duyu80/wolf/Baseboard/Release/Release/20150523/ReleaseNotes.txt

Baseboard_v0203
Status_v0106

Fix below issue

1) Reverse SGPIO Active signal to solve 20586
2) Correct power enable to solve 20539
