duyu80/wolf/Baseboard/BLD/Baseboard/synlog/report/Baseboard_Baseboard_fpga_mapper_notes.txt

@N: MF248 |Running in 64-bit mode.
@N: MF666 |Clock conversion enabled 
@N: BN362 :"e:\work\wolf\baseboard\bld\..\src\gpi.v":67:0:67:5|Removing sequential instance GPI0_INST.DOUT1[3] in hierarchy view:work.BB_TOP(verilog) because there are no references to its outputs 
@N: BN362 :"e:\work\wolf\baseboard\bld\..\src\gpi.v":79:0:79:5|Removing sequential instance GPI0_INST.DOUT2[3] in hierarchy view:work.BB_TOP(verilog) because there are no references to its outputs 
@N: BN362 :"e:\work\wolf\baseboard\bld\..\src\gpi.v":67:0:67:5|Removing sequential instance GPI8_INST.DOUT1[2] in hierarchy view:work.BB_TOP(verilog) because there are no references to its outputs 
@N: BN362 :"e:\work\wolf\baseboard\bld\..\src\gpi.v":79:0:79:5|Removing sequential instance GPI8_INST.DOUT2[2] in hierarchy view:work.BB_TOP(verilog) because there are no references to its outputs 
@N: BN362 :"e:\work\wolf\baseboard\bld\..\src\gpi.v":67:0:67:5|Removing sequential instance GPI9_INST.DOUT1[1] in hierarchy view:work.BB_TOP(verilog) because there are no references to its outputs 
@N: BN362 :"e:\work\wolf\baseboard\bld\..\src\gpi.v":79:0:79:5|Removing sequential instance GPI9_INST.DOUT2[1] in hierarchy view:work.BB_TOP(verilog) because there are no references to its outputs 
@N: BN362 :"e:\work\wolf\baseboard\bld\..\src\i2c.v":257:0:257:5|Removing sequential instance PORT_CSD1[15] of view:PrimLib.dffr(prim) in hierarchy view:work.I2C(verilog) because there are no references to its outputs 
@N: BN362 :"e:\work\wolf\baseboard\bld\..\src\i2c.v":257:0:257:5|Removing sequential instance PORT_CSD1[14] of view:PrimLib.dffr(prim) in hierarchy view:work.I2C(verilog) because there are no references to its outputs 
@N: BN362 :"e:\work\wolf\baseboard\bld\..\src\i2c.v":257:0:257:5|Removing sequential instance PORT_CSD1[13] of view:PrimLib.dffr(prim) in hierarchy view:work.I2C(verilog) because there are no references to its outputs 
@N: BN362 :"e:\work\wolf\baseboard\bld\..\src\i2c.v":257:0:257:5|Removing sequential instance PORT_CSD1[12] of view:PrimLib.dffr(prim) in hierarchy view:work.I2C(verilog) because there are no references to its outputs 
@N: BN362 :"e:\work\wolf\baseboard\bld\..\src\i2c.v":257:0:257:5|Removing sequential instance PORT_CSD1[11] of view:PrimLib.dffr(prim) in hierarchy view:work.I2C(verilog) because there are no references to its outputs 
@N: BN362 :"e:\work\wolf\baseboard\bld\..\src\i2c.v":257:0:257:5|Removing sequential instance PORT_CSD1[15] of view:PrimLib.dffr(prim) in hierarchy view:work.I2C_I2C_INS_2(verilog) because there are no references to its outputs 
@N: BN362 :"e:\work\wolf\baseboard\bld\..\src\i2c.v":257:0:257:5|Removing sequential instance PORT_CSD1[14] of view:PrimLib.dffr(prim) in hierarchy view:work.I2C_I2C_INS_2(verilog) because there are no references to its outputs 
@N: BN362 :"e:\work\wolf\baseboard\bld\..\src\i2c.v":257:0:257:5|Removing sequential instance PORT_CSD1[13] of view:PrimLib.dffr(prim) in hierarchy view:work.I2C_I2C_INS_2(verilog) because there are no references to its outputs 
@N: BN362 :"e:\work\wolf\baseboard\bld\..\src\i2c.v":257:0:257:5|Removing sequential instance PORT_CSD1[12] of view:PrimLib.dffr(prim) in hierarchy view:work.I2C_I2C_INS_2(verilog) because there are no references to its outputs 
@N: BN362 :"e:\work\wolf\baseboard\bld\..\src\i2c.v":257:0:257:5|Removing sequential instance PORT_CSD1[11] of view:PrimLib.dffr(prim) in hierarchy view:work.I2C_I2C_INS_2(verilog) because there are no references to its outputs 
@N: FX164 |The option to pack flops in the IOB has not been specified 
@N: BW106 |Synplicity Constraint File capacitance units using default value of 1pF 
@N: MT320 |Timing report estimates place and route data. Please look at the place and route timing report for final timing.
@N: MT322 |Clock constraints cover only FF-to-FF paths associated with the clock.
@N: MT320 |Timing report estimates place and route data. Please look at the place and route timing report for final timing.
@N: MT322 |Clock constraints cover only FF-to-FF paths associated with the clock.
