duyu80/wolf/Status/BLD/Status/synlog/report/Status_Status_fpga_mapper_notes.txt

@N: MF248 |Running in 64-bit mode.
@N: MF666 |Clock conversion enabled 
@N: BN362 :"e:\work\wolf\status\bld\..\src\i2c.v":257:0:257:5|Removing sequential instance PORT_CSD1[15] of view:PrimLib.dffr(prim) in hierarchy view:work.I2C(verilog) because there are no references to its outputs 
@N: BN362 :"e:\work\wolf\status\bld\..\src\i2c.v":257:0:257:5|Removing sequential instance PORT_CSD1[14] of view:PrimLib.dffr(prim) in hierarchy view:work.I2C(verilog) because there are no references to its outputs 
@N: BN362 :"e:\work\wolf\status\bld\..\src\i2c.v":257:0:257:5|Removing sequential instance PORT_CSD1[13] of view:PrimLib.dffr(prim) in hierarchy view:work.I2C(verilog) because there are no references to its outputs 
@N: BN362 :"e:\work\wolf\status\bld\..\src\i2c.v":257:0:257:5|Removing sequential instance PORT_CSD1[12] of view:PrimLib.dffr(prim) in hierarchy view:work.I2C(verilog) because there are no references to its outputs 
@N: BN362 :"e:\work\wolf\status\bld\..\src\i2c.v":257:0:257:5|Removing sequential instance PORT_CSD1[11] of view:PrimLib.dffr(prim) in hierarchy view:work.I2C(verilog) because there are no references to its outputs 
@N: BN362 :"e:\work\wolf\status\bld\..\src\i2c.v":257:0:257:5|Removing sequential instance PORT_CSD1[10] of view:PrimLib.dffr(prim) in hierarchy view:work.I2C(verilog) because there are no references to its outputs 
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
@N: BN362 :"e:\work\wolf\status\bld\..\src\i2c.v":257:0:257:5|Removing sequential instance PORT_CS[3] of view:PrimLib.dffr(prim) in hierarchy view:work.I2C(verilog) because there are no references to its outputs 
@N: BN362 :"e:\work\wolf\status\bld\..\src\i2c.v":257:0:257:5|Removing sequential instance PORT_CS[2] of view:PrimLib.dffr(prim) in hierarchy view:work.I2C(verilog) because there are no references to its outputs 
@N: FX164 |The option to pack flops in the IOB has not been specified 
@N: BW106 |Synplicity Constraint File capacitance units using default value of 1pF 
@N: MT320 |Timing report estimates place and route data. Please look at the place and route timing report for final timing.
@N: MT322 |Clock constraints cover only FF-to-FF paths associated with the clock.
@N: MT320 |Timing report estimates place and route data. Please look at the place and route timing report for final timing.
@N: MT322 |Clock constraints cover only FF-to-FF paths associated with the clock.
