duyu80/wolf/Status/code structure.pptx

tb_status.v

wb_master

Test bench

i2c_master_wb_top

TOP.v

HEADER.v

I2C.v

GPIO.v

LED_CNT.v

LED.v

SGPIO.v

SGPIO.v
