duyu80/wolf/Status/BLD/Status/syntmp/statusReport.html

Project Settings
Project Name | proj_1 | Implementation Name | Status
Top Module | TOP | Pipelining | 1
Retiming | 0 | Resource Sharing | 1
Fanout Guide | 1000 | Disable I/O Insertion | 0
Clock Conversion | 1 | FSM Compiler | 1

Run Status
Job Name | Status | | | | CPU Time | Real Time | Memory | Date/Time
Compile Input | Complete | 57 | 64 | 0 | - | 0m:01s | - | 2015/5/23 15:59:30
Pre-mapping | Complete | 6 | 1 | 0 | 0m:00s | 0m:00s | 141MB | 2015/5/23 15:59:32
Map & Optimize | Complete | 36 | 1 | 0 | 0m:06s | 0m:06s | 173MB | 2015/5/23 15:59:39

Area Summary
Register bits | 549 | I/O cells | 88
Block RAMs (v_ram) | 0 | DSPs (dsp_used) | 0
ORCA LUTs (total_luts) | 566

Timing Summary
Clock Name | Req Freq | Est Freq | Slack
TOP|SYSCLK | 1.0 MHz | 106.4 MHz | 498.252

Optimizations Summary
Combined Clock Conversion | 1 / 0
