duyu80/wolf/Baseboard/Release/BB_CPLD_Issue_list_1029DY.xlsx

No. | Date | Item | Version | Description | Priority | Status | Fixed Version | DY Comments
1 | 2014-10-28 | Slave address doesn't match the spec |  | Spec defined: 0xC2 for CPLD 1, C4 for CPLD 2 |  |  | 01(This is the temp version number only for debug, you can read back from 0x06) | Done
2 | 2014-10-28 | Drive present register doesn't match the spec |  | Sepc defined: If the value of the bit is 0b, then means no drive is installed. If the bit is 1b, then means the drive is installed. |  |  | 01 | Done
3 | 2014-10-28 | Drive power can not control |  |  |  |  |  | Last version is only for debug, as quake's requirement, I just enable all HDDs when power on. Please try today's version.
4 | 2014-10-28 | SSM present not detected. |  |  |  |  |  | I did not find "STATUS_BOARD_PRSENT" pin in Schematic, I am not sure whether I get the latest schematic. And also, I have a question, in spec, this register is wr/rd register, but if this signal is from SSM board, I think this register should be read only. Please check it with hudson and EE. Thanks
5 | 2014-10-28 | SGPIO not work |  |  |  |  |  | 1) Please let me know your test procedure. 2) Please make sure SSM already programmed.
6 | 2014-10-28 | Drive number in Drive Slot Signal Register doesn't match the spec. |  | plug drive to slot 1, drive present is reported in BB CPLD 1 register 0x13. plug drive to slot 13, drive present is reported in BB CPLD 2 register 0x13. |  |  |  | Please let me know the net name in schematic for the drive you plug in. For example, DRV0_PRSNT_AMBER_LED is for the slot 0. And also, please notice that the drive number begin from 1 in spec, but in schematic, it begin from 0.
