duyu80/wolf/Baseboard/Release/BB_CPLD_Issue_list_1030DY.xlsx

No. | Date | Item | Version | Description | Priority | Status | Fixed Version | DY Comments
1 | 2014-10-28 | Slave address doesn't match the spec |  | Spec defined: 0xC2 for CPLD 1, C4 for CPLD 2 |  | closed | 01(This is the temp version number only for debug, you can read back from 0x06) | Done
2 | 2014-10-28 | Drive present register doesn't match the spec |  | Sepc defined: If the value of the bit is 0b, then means no drive is installed. If the bit is 1b, then means the drive is installed. |  | closed | 01 | Done
3 | 2014-10-28 | Drive power can not control |  |  |  |  | 02 | 2014/10/30 DY: I have fixed this bug in 02 version, please help verify and close this issue. And also, according to your requirement, I have modified the default power state to power on. 2014/10/29 David: Keep HDD powered on in the bringup stage. In rev 01, drive is not powered on. Last version is only for debug, as quake's requirement, I just enable all HDDs when power on. Please try today's version.
4 | 2014-10-28 | SSM present not detected. |  |  |  | closed |  | 2014/10/29 David: STATUS_BOARD_PRSENT is connected to the MI CPLD.SAS firmware will write this register to let BB CPLD known the presence of the status board. I did not find "STATUS_BOARD_PRSENT" pin in Schematic, I am not sure whether I get the latest schematic. And also, I have a question, in spec, this register is wr/rd register, but if this signal is from SSM board, I think this register should be read only. Please check it with hudson and EE. Thanks
5 | 2014-10-28 | SGPIO not work |  |  |  |  |  | 2014/10/29 David: I insert a drive and start Iometer, but no LED bliking on the SSM. Maybe releated to the STATUS_BOARD_PRESENT register. Will double check later. 1) Please let me know your test procedure. 2) Please make sure SSM already programmed.
6 | 2014-10-28 | Drive number in Drive Slot Signal Register doesn't match the spec. |  | plug drive to slot 1, drive present is reported in BB CPLD 1 register 0x13. plug drive to slot 13, drive present is reported in BB CPLD 2 register 0x13. |  |  |  | 2014/1029 David: The drive slot sequence on Baseboard is like below: ----------------MidPlane---------------- | HDD 49 -> HDD 60 HDD 61 -> HDD 72 | | HDD 25 -> HDD 36 HDD 37 -> HDD 48 | | HDD 1 -> HDD 12 HDD 13 -> HDD 24 | ------------------SSM------------------- This sequence is different from the connector net name, which is: ----------------MidPlane---------------- | J1 -> J12 J13 -> J24 | | J25 -> J36 J37 -> J48 | | J49 -> J60 J61 -> J72 | ------------------SSM------------------- You can refer to the BB schematic page 3. Please let me know the net name in schematic for the drive you plug in. For example, DRV0_PRSNT_AMBER_LED is for the slot 0. And also, please notice that the drive number begin from 1 in spec, but in schematic, it begin from 0.
