duyu80/wolf/Baseboard/Release/Release/20150316/ReleaseNotes.txt

Status_v0103
Fix below issue
D-0020588    0-None    Proposed Fix    <EVT FW SSM CPLD> Mapping of Register 11h,13h and LEDs are incorrect.‍
