duyu80/wolf/Baseboard/Release/Release/20150214/ReleaseNotes.txt

Baseboard_v0105
1)Fix power ok and clock sequence issue
2)Modify net name in source code top file according to schematic
