duyu80/wolf/Baseboard/Release/WC_CPLD_salesforce_bug_list.xlsx

1 | D-0020567 (https://c.na13.visual.force.com/apex/Actions_View?sfdc.override=1&id=a02a000000LXvXfAAL) | 0-None | Assigned | <EVT FW BB CPLD> Register 80h 0b/1b is reversed to reflect the low active signal. | [Hardware] Controller - P/N: PBA001540B-B03 EVT, SN: JD46140014 Midplane - P/N: PBA001528A-A03, SN: JD37140690 BB - P/N: PBA001529A-A04 EVT, SN: JD40140030 [SW/FW Ver: Package 1] Controller CPLD: V01.08 MI CPLD: V01.03 SXP: 0110[3257] BMC: V005 Bios: V0101 BB CPLD: V01.02 SSM CPLD: V01.01 [Description] As design spec definition, 1b means asserted, 0b means de-asserted, so for the loa active signals, 1b means signal high, 0b means signal low. But 80[0:1] are 1b when CANISTER_A/B_PCIE_CLK_ACT_L are high, and 0b when CANISTER_A/B_PCIE_CLK_ACT_L are low. It's reversed. Reprocude Step: 1. Power on system, and ctrl+D in Primary SXP debug port to let SXP into Bootloader. 2. Read 80h with Aardvark of CPLD 1. they are 0x03. 3. Probe CANISTER_A_PCIE_CLK_ACT_L is 3.3V(controller A inserted), CANISTER_B_PCIE_CLK_ACT_L is 2.4V(No controller B, 3.3V when B inserted) 4. Drive CANISTER_A_PCIE_CLK_ACT_L to Ground, read 80h again, it's 0x02. 5. Release CANISTER_A_PCIE_CLK_ACT_L, drive CANISTER_B_PCIE_CLK_ACT_L to Ground, read 80h again, it's 0x01. | Fix it in Baseboard_v0106, please verify
2 | D-0020797 (https://c.na13.visual.force.com/apex/Actions_View?sfdc.override=1&id=a02a000000LgLy5AAF) | 0-None | Assigned | <EVT FW BB CPLD> BB CPLD1/2 couldn't be reset by BB_CPLD1/2_RST_L signal. | [Hardware] Controller - P/N: PBA001540B-B03 EVT, SN: JD46140014 Midplane - P/N: PBA001528A-A03, SN: JD37140690 BB - P/N: PBA001529A-A04 EVT, SN: JD40140030 [SW/FW Ver: Package 1] Controller CPLD: V01.08 MI CPLD: V01.03 SXP: 0110[3257] BMC: V005 Bios: V0101 BB CPLD: V01.02 SSM CPLD: V01.01 [Description] MI CPLD register 40h BB_CPLD1/2_RST is required to drive BB_CPLD1/2_RST_L signal, and BB CPLD1/2 will be kept reset. But after write 40h with data 0x03, BB_CPLD_1/2_RST_L signal are low correctly, but CPLD1, CPLD2 isn't reset. Reproduce Step: 1. Power on system, then switch to Primary SXP Uart by hotkey Ctrl+^ c. 2. Read MI CPLD register 40h by "cpld reg mi 0x40", check if it's 0x00. 3. Read BB CPLD1 register 00 by "cpld reg bb1 0x00", check if it's 0x25. 4. Write MI CPLD "cpld reg mi 0x40 0x01", read it again, check if it's 0x01. 5. Probe siganl BB_CPLD1_RST_L is low. 6. Read BB CPLD1 register 00 by "cpld reg bb1 0x00", chekc if it's still read out. | Fix it in Baseboard_v0106, please verify
3 | D-0020536 (https://c.na13.visual.force.com/apex/Actions_View?sfdc.override=1&id=a02a000000LfPgNAAV) | 0-None | Assigned | <EVT FW BB/SSM CPLD> There is no chip ID register in BB CPLD and SSM CPLD | [Hardware] Controller - P/N: PBA001540B-B03 EVT, SN: JD46140014 Midplane - P/N: PBA001528A-A03, SN: JD37140690 BB - P/N: PBA001529A-A04 EVT, SN: JD40140030 [SW/FW Ver: Package 1] Controller CPLD: V01.08 MI CPLD: V01.03 SXP: 0110[3257] BMC: V005 Bios: V0101 BB CPLD: V01.02 SSM CPLD: V01.01 [Description] In Controller and MI Design spec, there is chipID(02h) register for every chip in Wolf Creek system including Controller, MI, BB1, BB2, SSM. But in BB(Baseboard)CPLD, SSM CPLD there isn't define the ChipID register, and there is no this register in the BB and SSM CPLD. And It looks the whole Block Header registers defined in BB/SSM are much different with Controller/MI CPLD design, it should be consistent.
4 | D-0020586 (https://c.na13.visual.force.com/apex/Actions_View?sfdc.override=1&id=a02a000000LfSXNAA3) | 0-None | Assigned | <EVT FW BB CPLD> Register A0h hasn't control SGPIO outputs enbale or disable. | [Hardware] Controller - P/N: PBA001540B-B03 EVT, SN: JD46140014 Midplane - P/N: PBA001528A-A03, SN: JD37140690 BB - P/N: PBA001529A-A04 EVT, SN: JD40140030 [SW/FW Ver: Package 1] Controller CPLD: V01.08 MI CPLD: V01.03 SXP: 0110[3257] BMC: V005 Bios: V0101 BB CPLD: V01.02 SSM CPLD: V01.01 [Description] As design spec V0.8, only when the register STATUS_BOARD_PRSENT asserted, SGPIO outputs are enabled to output ACTIVITY LED signals to SSM, otherwise SGPIO outputs always are disabled and no actionA0h STATUS_BOARD_PRSENT. But when 80h is 0x00, Activity LED still ON. Reproduce Step: 1. Insert some HDDs, and power on system into OS. 2. Read regsiter A0h is 0x00 in Primary SXP debug port. 3. Use IO meter to trigger HDD activity. 3. Check the HDD Activity LED on the SSM Board. they are blink. | Fix it in Baseboard_v0107, please verify
5 | D-0020539 (https://c.na13.visual.force.com/apex/Actions_View?sfdc.override=1&id=a02a000000LfPgcAAF) | 0-None | Assigned | <EVT FW BB CPLD> DRIVE_xx_PWROK register couldn't reflect Drv[x]_PWR_EN_L signal state. | [Hardware] Controller - P/N: PBA001540B-B03 EVT, SN: JD46140014 Midplane - P/N: PBA001528A-A03, SN: JD37140690 BB - P/N: PBA001529A-A04 EVT, SN: JD40140030 [SW/FW Ver: Package 1] Controller CPLD: V01.08 MI CPLD: V01.03 SXP: 0110[3257] BMC: V005 Bios: V0101 BB CPLD: V01.02 SSM CPLD: V01.01 [Description] 1. Power OK register response different values even all the Drv[x]_PWR_EN_L signal are high. 2. Power OK value will not reflect the state of Drv[x]_PWR_EN_L even it changes. | Fix it in Baseboard_v0107, please verify
6 | D-0020541 (https://c.na13.visual.force.com/apex/Actions_View?sfdc.override=1&id=a02a000000LfPgmAAF) | 0-None | Assigned | <EVT FW BB CPLD> LED blink doesn't following the corresponding toggle rate. | [Hardware] Controller - P/N: PBA001540B-B03 EVT, SN: JD46140014 Midplane - P/N: PBA001528A-A03, SN: JD37140690 BB - P/N: PBA001529A-A04 EVT, SN: JD40140030 [SW/FW Ver: Package 1] Controller CPLD: V01.08 MI CPLD: V01.03 SXP: 0110[3257] BMC: V005 Bios: V0101 BB CPLD: V01.02 SSM CPLD: V01.01 [Description] IFDET_BLUE_LED and PRSNT_AMBER_LED blink hasn't follow the toggle rate when rate is 0010, 0110 and 0111. 1. Toggle rate 0010 cause LED is ON 1 sec and OFF 1 sec which should be 500ms ON and 500ms OFF as design. 2. Toggle rate 0110 request "Repeated cycle of alternating between on and off at 4 Hz with a 50% duty cycle twice then on for a period of 500 milliseconds", but in fact it's 4 Hz with a 50% duty cycle twice then OFF in 500 ms. 3. Toggle rate 0111 request "Repeated cycle of alternating between on and off at 4 Hz with a 50% duty cycle twice then on for a period of 3.5 seconds", but infact it's 4 Hz with a 50% duty cycle twice then OFF in 3.5 seconds. Please refer to the attached snapshot for Reproduce Step: 1. Power on system, and ctrl+D in Primary SXP debug port to let SXP into Bootloader. 2. Wrtie register 0x70 with data 0x22, then check the HDD Fault and Identity LED is blink with ON and OFF simultaneously. 3. Probe DRV21_IFDET_BLUE_LED in HDD70 with oscilloscope to check the phase of the signal. the 50% duty cycle is 1s. | Fix it in Baseboard_v0107, please verify
7 | D-0020537 (https://c.na13.visual.force.com/apex/Actions_View?sfdc.override=1&id=a02a000000LfPgSAAV) | 0-None | Assigned | <EVT FW BB/SSM CPLD> Sequential read doesn't take effect in BB CPLD and SSM CPLD | [Hardware] Controller - P/N: PBA001540B-B03 EVT, SN: JD46140014 Midplane - P/N: PBA001528A-A03, SN: JD37140690 BB - P/N: PBA001529A-A04 EVT, SN: JD40140030 [SW/FW Ver: Package 1] Controller CPLD: V01.08 MI CPLD: V01.03 SXP: 0110[3257] BMC: V005 Bios: V0101 BB CPLD: V01.02 SSM CPLD: V01.01 [Description] As design spec, register read operations support Sequential read in BB CPLD and SSM CPLD. But it couldn't take effect. Reproduce steps: 1. Adapt Sequential register read to read BB CPLD 6 registers (0x06 through 0x05) via Aardvark GUI. 2. Check the responsed data 20 FF FF FF FF FF. 3. Random register read BB CPLD register 0x00, 0x01, 0x02, 0x03, 0x04, 0x05. 4. Check the responsed data each operation, they are 20, 14, 01, 02, 00, C9 | Fix it in Baseboard_v0109, please verify
8 | D-0020540 (https://c.na13.visual.force.com/apex/Actions_View?sfdc.override=1&id=a02a000000LfPghAAF) | 0-None | Assigned | <EVT FW BB CPLD> Protected Access Register couldn't be protected by protected key. | [Hardware] Controller - P/N: PBA001540B-B03 EVT, SN: JD46140014 Midplane - P/N: PBA001528A-A03, SN: JD37140690 BB - P/N: PBA001529A-A04 EVT, SN: JD40140030 [SW/FW Ver: Package 1] Controller CPLD: V01.08 MI CPLD: V01.03 SXP: 0110[3257] BMC: V005 Bios: V0101 BB CPLD: V01.02 SSM CPLD: V01.01 [Description] Drive Power Enable register is Protected Access Register, but it can be wrriten without any protet key as precedence. Reproduce Step: 1. Insert SAS HDD into HDD71. 2. Power on system, and ctrl+D in Primary SXP debug port to let SXP into Bootloader. 2. Read DRIVE_x_PWR_EN register 0x24, it's 0x0F, probe Drv[71]_PWR_EN_L to check if it's low. 3. Write register 0x24 with data 0x0D directly without Protect Key, then read 24h to check if return data is 0x0D 4. Check probe Drv[71]_PWR_EN_L to check if it's high. | Fix it in Baseboard_v0108, please verify
9 | D-0020566 (https://c.na13.visual.force.com/apex/Actions_View?sfdc.override=1&id=a02a000000LXvXVAA1) | 0-None | Assigned | <EVT FW BB CPLD> HDD present status change hasn't trigger Alert | [Hardware] Controller - P/N: PBA001540B-B03 EVT, SN: JD46140014 Midplane - P/N: PBA001528A-A03, SN: JD37140690 BB - P/N: PBA001529A-A04 EVT, SN: JD40140030 [SW/FW Ver: Package 1] Controller CPLD: V01.08 MI CPLD: V01.03 SXP: 0110[3257] BMC: V005 Bios: V0101 BB CPLD: V01.02 SSM CPLD: V01.01 [Description] As BB Design spec V0.8, Alert register 90h bit[0] will be set once HDD present status change, but in fact, the register bit always 0b, doen't set based on the HDD insert or remove. Reproduce Step: 1. Power on system, and ctrl+D in Primary SXP debug port to let SXP into Bootloader. 2. Read 90h with Aardvark of CPLD 1 and 2. they are 0x00. 3. Insert HDD on Slot 1, then read 90h of CPLD1, it's still 0x00. 4. Read 90h of CPLD2, it's still 0x00. 5. Try other HDD to check 90h, it always 0x00 without changing after HDD insert or remove. | Fix it in Baseboard_v0109, please verify
10 | D-0020538 (https://c.na13.visual.force.com/apex/Actions_View?sfdc.override=1&id=a02a000000LfPgXAAV) | 0-None | Assigned | <EVT FW BB CPLD> Defalut value of some regsiters are not compliant with desgin spec | [Hardware] Controller - P/N: PBA001540B-B03 EVT, SN: JD46140014 Midplane - P/N: PBA001528A-A03, SN: JD37140690 BB - P/N: PBA001529A-A04 EVT, SN: JD40140030 [SW/FW Ver: Package 1] Controller CPLD: V01.08 MI CPLD: V01.03 SXP: 0110[3257] BMC: V005 Bios: V0101 BB CPLD: V01.02 SSM CPLD: V01.01 [Description] 1. Drive Type register default value is 0xFF but should be 0x00 as design spec defined. 2. Power Enable register are design 0x00 as default, but all are 0xFF(20h ~24h) after POR. 3. 24[7:4] is reserved and default as 0000b, but it return 1111b as default, and could be written with 0b or 1b. | The driver type's default value is decide by hardware not CPLD, if "0" means SATA Driver, if "1" means PCIE Driver Fix it in Baseboard_v0107, please verify
11
12 | D-0020587 (https://c.na13.visual.force.com/apex/Actions_View?sfdc.override=1&id=a02a000000LfSXSAA3) | 0-None | Assigned | <EVT FW SSM CPLD> Most pattern of LED blinking don't match the corresponding toggle rate. | [Hardware] Controller - P/N: PBA001540B-B03 EVT, SN: JD46140014 Midplane - P/N: PBA001528A-A03, SN: JD37140690 BB - P/N: PBA001529A-A04 EVT, SN: JD40140030 [SW/FW Ver: Package 1] Controller CPLD: V01.08 MI CPLD: V01.03 SXP: 0110[3257] BMC: V005 Bios: V0101 BB CPLD: V01.02 SSM CPLD: V01.01 [Description] All the toogle rate is failed to trigger LED blink in the correct pattern except 0010b, which should exist all LED registers in SSM. And 1000b~1111F definition in SSM Spec v0.4 isn't compatible with them in BB CPLD Spec V0.8, suggest it should be the same definition. 1. 0000b should let LED on, but it's off. 2. 0011b should be The indicator alternates between on and off at a 2Hz rate with a 50% duty cycle. but it's "4Hz rate with a 50% duty cycle". 3. 0010b blinks fast than "4Hz rate with a 50% duty cycle". 4. 0101b isn't follow "Repeated cycle of alternating between 0.7s on and 0.7s off". 5. 0111b and 00111b test is blocked, untill BB CPLD LED issue D-0020541 fixed, because SSM LED pattern hard to be probed, test method is cmoparing the LED blink between SSM and HDD Drive in BB. But suggest debug it as other pattern before release. 6. 1000b~1111b have been written and let the LED Solid on, which should be not written as design. Reproduce Report: 1. Insert SAS HDD into HDD24, power on system, and ctrl+D in Primary SXP debug port to let SXP into Bootloader. 2. Wrtie register 0x45 with data 0x30 in BB2, and write register 0x10 with data 0x33 in SSM, then compare the LEDs in SSM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 | Fix it in Status_v0102
13 | D-0020588 (https://c.na13.visual.force.com/apex/Actions_View?sfdc.override=1&id=a02a000000LfSXXAA3) | 0-None | Proposed Fix | <EVT FW SSM CPLD> Mapping of Register 11h,13h and LEDs are incorrect. | [Hardware] Controller - P/N: PBA001540B-B03 EVT, SN: JD46140014 Midplane - P/N: PBA001528A-A03, SN: JD37140690 BB - P/N: PBA001529A-A04 EVT, SN: JD40140030 [SW/FW Ver: Package 1] Controller CPLD: V01.08 MI CPLD: V01.03 SXP: 0110[3257] BMC: V005 Bios: V0101 BB CPLD: V01.02 SSM CPLD: V01.01 [Description] In SSM design Spec v0.4, 11h[0:3] is COVER_OPEN_AMBER_LED, 11h[4:7] is Reserved. 13h[0:3] is COM_FLT_AMBER_LED, 11h[4:7] is DRIVE_FLT_AMBER_LED. But the test result in V01.01, 11h[0:3] is COVER_OPEN_AMBER_LED, 11h[4:7] is COM_FLT_AMBER_LED. 13h hasn't mapped any LED. 12h[0:3] is DRIVE_FLT_AMBER_LED. | Fix it in Status_v0102
