duyu80/wolf/Baseboard/Release/Release/20150510/ReleaseNotes.txt

Baseboard_v010a

Fix below issue

D-0020539: <EVT FW BB CPLD> DRIVE_xx_PWROK register couldn't reflect Drv[x]_PWR_EN_L signal state.
