duyu80/wolf/Baseboard/Release/Release/20150426/ReleaseNotes.txt

Status_v0104
Fix below issue
<EVT FW BB/SSM CPLD> Sequential read doesn't take effect in SSM CPLD
