duyu80/wolf/Baseboard/Release/Release/20150310/ReleaseNotes.txt

Baseboard_v0108
Fix below issue
D-0020540	0-None	Assigned	<EVT FW BB CPLD> Protected Access Register couldn't be protected by protected key.
