duyu80/wolf/Baseboard/SRC/PCIE_RST_CTRL.v

//************************************************************************
//**                          Baseboard CPLD							**
//**                          PCIE_RST_CTRL.v                           **
//************************************************************************ 

//**********************      ChangeList      *****************************

`include "../SRC/baseboard_define.v"

module PCIE_RST_CTRL (

            // Driver power ok input
            input       DRV3_PWROK,DRV2_PWROK,DRV1_PWROK,DRV0_PWROK,
            input       DRV7_PWROK,DRV6_PWROK,DRV5_PWROK,DRV4_PWROK,
            input       DRV11_PWROK,DRV10_PWROK,DRV9_PWROK,DRV8_PWROK,
            input       DRV15_PWROK,DRV14_PWROK,DRV13_PWROK,DRV12_PWROK,
            input       DRV19_PWROK,DRV18_PWROK,DRV17_PWROK,DRV16_PWROK,
            input       DRV23_PWROK,DRV22_PWROK,DRV21_PWROK,DRV20_PWROK,
            // PCIE reset portA output
            output reg  PE_RST_DRV3_A_L,PE_RST_DRV2_A_L,PE_RST_DRV1_A_L,PE_RST_DRV0_A_L,
            output reg  PE_RST_DRV7_A_L,PE_RST_DRV6_A_L,PE_RST_DRV5_A_L,PE_RST_DRV4_A_L,
            output reg  PE_RST_DRV11_A_L,PE_RST_DRV10_A_L,PE_RST_DRV9_A_L,PE_RST_DRV8_A_L,
            output reg  PE_RST_DRV15_A_L,PE_RST_DRV14_A_L,PE_RST_DRV13_A_L,PE_RST_DRV12_A_L,
            output reg  PE_RST_DRV19_A_L,PE_RST_DRV18_A_L,PE_RST_DRV17_A_L,PE_RST_DRV16_A_L,
            output reg  PE_RST_DRV23_A_L,PE_RST_DRV22_A_L,PE_RST_DRV21_A_L,PE_RST_DRV20_A_L,
            // PCIE reset portB output
            output reg  PE_RST_DRV3_B_L,PE_RST_DRV2_B_L,PE_RST_DRV1_B_L,PE_RST_DRV0_B_L,
            output reg  PE_RST_DRV7_B_L,PE_RST_DRV6_B_L,PE_RST_DRV5_B_L,PE_RST_DRV4_B_L,
            output reg  PE_RST_DRV11_B_L,PE_RST_DRV10_B_L,PE_RST_DRV9_B_L,PE_RST_DRV8_B_L,
            output reg  PE_RST_DRV15_B_L,PE_RST_DRV14_B_L,PE_RST_DRV13_B_L,PE_RST_DRV12_B_L,
            output reg  PE_RST_DRV19_B_L,PE_RST_DRV18_B_L,PE_RST_DRV17_B_L,PE_RST_DRV16_B_L,
            output reg  PE_RST_DRV23_B_L,PE_RST_DRV22_B_L,PE_RST_DRV21_B_L,PE_RST_DRV20_B_L,
            // System
			input     SYSCLK,
			input     RESET_N
			
            );

//PCIE RESET 0
reg       [31:0]  CNT0;
always@(posedge SYSCLK or negedge RESET_N)
	begin
		if(RESET_N == 1'b0)
			begin
				CNT0                  <= 'b0;
				PE_RST_DRV0_A_L       <= 'b0;
				PE_RST_DRV0_B_L       <= 'b0;
			end
		else
		    begin
				CNT0                  <= ((CNT0 < `TIME_100MS) && (DRV0_PWROK == 1'b1))? (CNT0 + 32'h1) : ((DRV0_PWROK == 1'b1)? CNT0 : 0);
				PE_RST_DRV0_A_L       <= (CNT0 < `TIME_100MS)? 1'b0 : 1'b1;
				PE_RST_DRV0_B_L       <= (CNT0 < `TIME_100MS)? 1'b0 : 1'b1;
			end
	end
//PCIE RESET 1
reg       [31:0]  CNT1;
always@(posedge SYSCLK or negedge RESET_N)
	begin
		if(RESET_N == 1'b0)
			begin
				CNT1                  <= 'b0;
				PE_RST_DRV1_A_L       <= 'b0;
				PE_RST_DRV1_B_L       <= 'b0;
			end
		else
		    begin
				CNT1                  <= ((CNT1 < `TIME_100MS) && (DRV1_PWROK == 1'b1))? (CNT1 + 32'h1) : ((DRV1_PWROK == 1'b1)? CNT1 : 0);
				PE_RST_DRV1_A_L       <= (CNT1 < `TIME_100MS)? 1'b0 : 1'b1;
				PE_RST_DRV1_B_L       <= (CNT1 < `TIME_100MS)? 1'b0 : 1'b1;
			end
	end
//PCIE RESET 2
reg       [31:0]  CNT2;
always@(posedge SYSCLK or negedge RESET_N)
	begin
		if(RESET_N == 1'b0)
			begin
				CNT2                  <= 'b0;
				PE_RST_DRV2_A_L       <= 'b0;
				PE_RST_DRV2_B_L       <= 'b0;
			end
		else
		    begin
				CNT2                  <= ((CNT2 < `TIME_100MS) && (DRV2_PWROK == 1'b1))? (CNT2 + 32'h1) : ((DRV2_PWROK == 1'b1)? CNT2 : 0);
				PE_RST_DRV2_A_L       <= (CNT2 < `TIME_100MS)? 1'b0 : 1'b1;
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
			end
	end
//PCIE RESET 22
reg       [31:0]  CNT22;
always@(posedge SYSCLK or negedge RESET_N)
	begin
		if(RESET_N == 1'b0)
			begin
				CNT22                  <= 'b0;
				PE_RST_DRV22_A_L       <= 'b0;
				PE_RST_DRV22_B_L       <= 'b0;
			end
		else
		    begin
				CNT22                  <= ((CNT22 < `TIME_100MS) && (DRV22_PWROK == 1'b1))? (CNT22 + 32'h1) : ((DRV22_PWROK == 1'b1)? CNT22 : 0);
				PE_RST_DRV22_A_L       <= (CNT22 < `TIME_100MS)? 1'b0 : 1'b1;
				PE_RST_DRV22_B_L       <= (CNT22 < `TIME_100MS)? 1'b0 : 1'b1;
			end
	end
//PCIE RESET 23
reg       [31:0]  CNT23;
always@(posedge SYSCLK or negedge RESET_N)
	begin
		if(RESET_N == 1'b0)
			begin
				CNT23                  <= 'b0;
				PE_RST_DRV23_A_L       <= 'b0;
				PE_RST_DRV23_B_L       <= 'b0;
			end
		else
		    begin
				CNT23                  <= ((CNT23 < `TIME_100MS) && (DRV23_PWROK == 1'b1))? (CNT23 + 32'h1) : ((DRV23_PWROK == 1'b1)? CNT23 : 0);
				PE_RST_DRV23_A_L       <= (CNT23 < `TIME_100MS)? 1'b0 : 1'b1;
				PE_RST_DRV23_B_L       <= (CNT23 < `TIME_100MS)? 1'b0 : 1'b1;
			end
	end

endmodule
