duyu80/wolf/(commit log)

2015-02-11 20141109 version initial check in
    [BBmapping.xlsx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]
2015-02-11 BB v0103 fix pcie reset issue
    [PCIE_RST_CTRL.pp.v, PCIE_RST_CTRL.v, baseboard_define.v, tb_baseboard.pp.v, tb_baseboard.v]
2015-02-12 Important check in to correct pin assignment and remove pull-down resistor
    [BBmapping.xlsx]
2015-02-14 Baseboard_v0105 1)Fix power ok and clock sequence issue 2)Modify net name in source code top file according to schematic
    [BBmapping.xlsx]
2015-02-25 Add bug list
    [WC_CPLD_salesforce_bug_list.xlsx]
2015-02-25 Baseboard_v0106 1)Fix D-0020567 --- <EVT FW BB CPLD> Register 80h 0b/1b is reversed to reflect the low active signal. 2)Fix D-0020797 --- <EVT FW BB CPLD> BB CPLD1/2 couldn't be reset by BB_CPLD1/2_R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
    [WC_CPLD_salesforce_bug_list.xlsx]
2015-03-08 Baseboard_v0107 Fix below issue 1) D-0020586 0-None Assigned <EVT FW BB CPLD> Register A0h hasn't control SGPIO outputs enbale or disable. 2) D-0020539 0-None Assigned <EVT FW BB CPLD> DRIVE_xx_PWROK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
    [WC_CPLD_salesforce_bug_list.xlsx]
2015-03-10 Baseboard_v0108 Fix below issue D-0020540 0-None Assigned <EVT FW BB CPLD> Protected Access Register couldn't be protected by protected key.
    [WC_CPLD_salesforce_bug_list.xlsx]
2015-03-11 Status_v0102 Fix below issue D-0020587 0-None Assigned <EVT FW SSM CPLD> Most pattern of LED blinking don't match the corresponding toggle rate. D-0020588 0-None Proposed Fix <EVT FW SSM CPLD> Mappin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
    [WC_CPLD_salesforce_bug_list.xlsx]
2015-03-14 Baseboard_v0109 Fix below issue D-0020537 0-None Assigned <EVT FW BB/SSM CPLD> Sequential read doesn't take effect in BB CPLD and SSM CPLD D-0020566 0-None Assigned <EVT FW BB CPLD> HDD present statu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
    [WC_CPLD_salesforce_bug_list.xlsx]
2015-03-16 Status_v0103 Fix below issue D-0020588 0-None Proposed Fix <EVT FW SSM CPLD> Mapping of Register 11h,13h and LEDs are incorrect.‍
    [TOP.pp.v, TOP.v, status_define.v]
2015-04-26 Status_v0104 Fix below issue <EVT FW BB/SSM CPLD> Sequential read doesn't take effect in SSM CPLD
    [I2C.v, status_define.v]
2015-04-28 Status_v0105
    Fix below issue
    1) <EVT FW BB/SSM CPLD> Sequential read doesn't take effect in SSM CPLD
    2) <EVT FW BB CPLD> Register A0h hasn't control SGPIO outputs enbale or disable.
    [TOP.pp.v, TOP.v, status_define.v]
2015-04-29 remove no use things
    [PCIe_SSD_Mapping.xlsx]
2015-05-10 Baseboard_v010a
    D-0020539: <EVT FW BB CPLD> DRIVE_xx_PWROK register couldn't reflect Drv[x]_PWR_EN_L signal state.
    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
    [BB_TOP.pp.v, BB_TOP.v, baseboard_define.v]
2015-05-19 1) Revert SGPIO Active signal to solve 20586 2) Correct power enable to solve 20539
    [BB_SGPIO.pp.v, BB_SGPIO.v, BB_TOP.pp.v, BB_TOP.v, baseboard_define.v]
2015-05-19 Baseboard_v0202
    1) Reverse SGPIO Active signal to solve 20586
    2) Correct power enable to solve 20539
    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
2015-05-23 Baseboard_v0203 Status_v0106
    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
    [BB_TOP.pp.v, BB_TOP.v, baseboard_define.v, status_define.v]
